piersfinlayson/airfrog-pcb/images/airfrog-c3-bottom.png

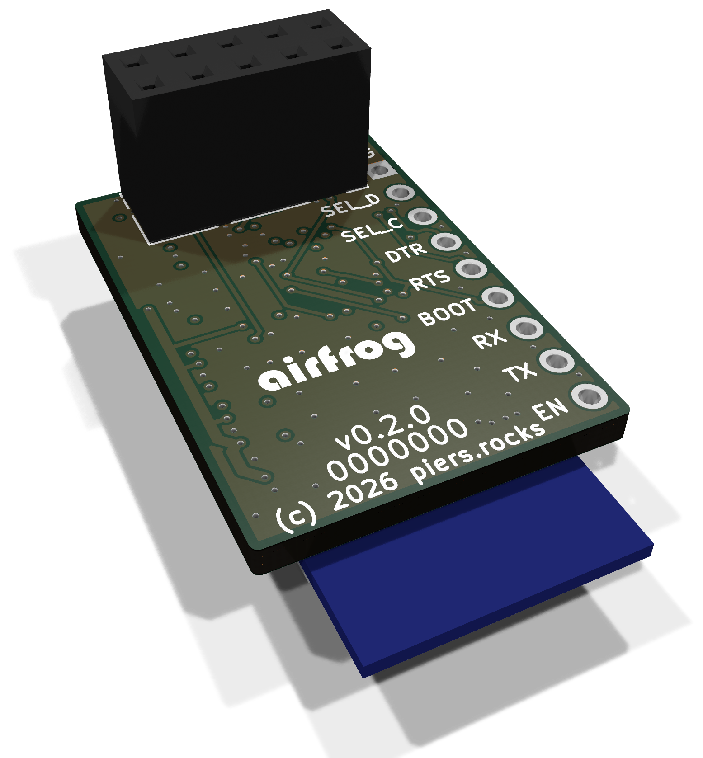
images/airfrog-c3-bottom.png
