piersfinlayson/airfrog-pcb/images/airfrog-s3-bottom.png

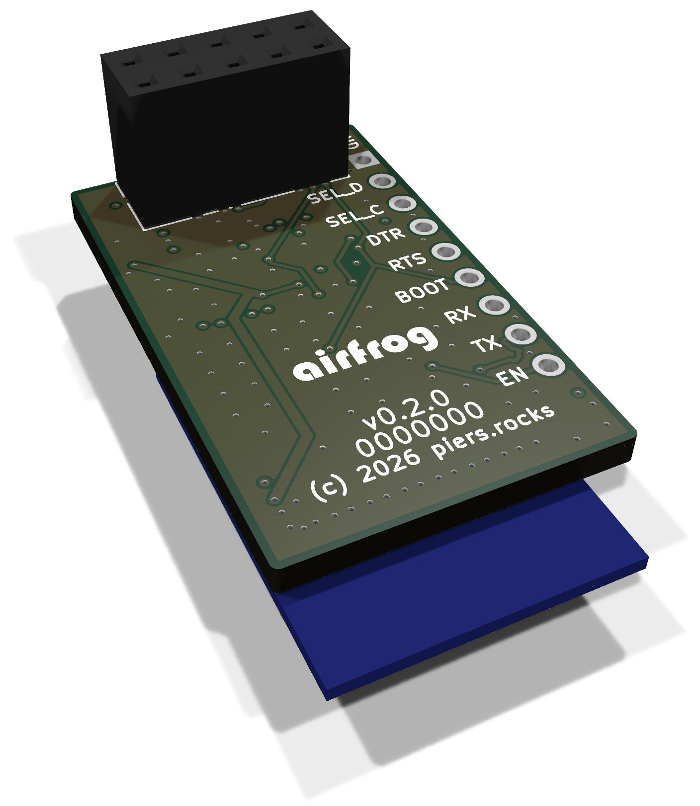
images/airfrog-s3-bottom.png
