piersfinlayson/airfrog-pcb/CHANGELOG.md

# Changelog

All notable changes between versions are documented in this file.

## v0.2.0 - 2026-10-29

Airfrog for One ROM Fire USB boards in ESP32-C3 and ESP32-S3 variants.

Supports all recent One ROM models including fire-24-c onwards, and all Fire 28, 32 and 40 pin versions.

Untested.
